Zabot/retrotype/README.md

# Retrotype
A control board retrofit for the Brother Comptronic 300M to convert it to an
RS232 teleprinter.
