Zabot/retrotype/pcb/drivers.kicad_sch

## KiCad design pcb/drivers.kicad_sch (2022-07-16)

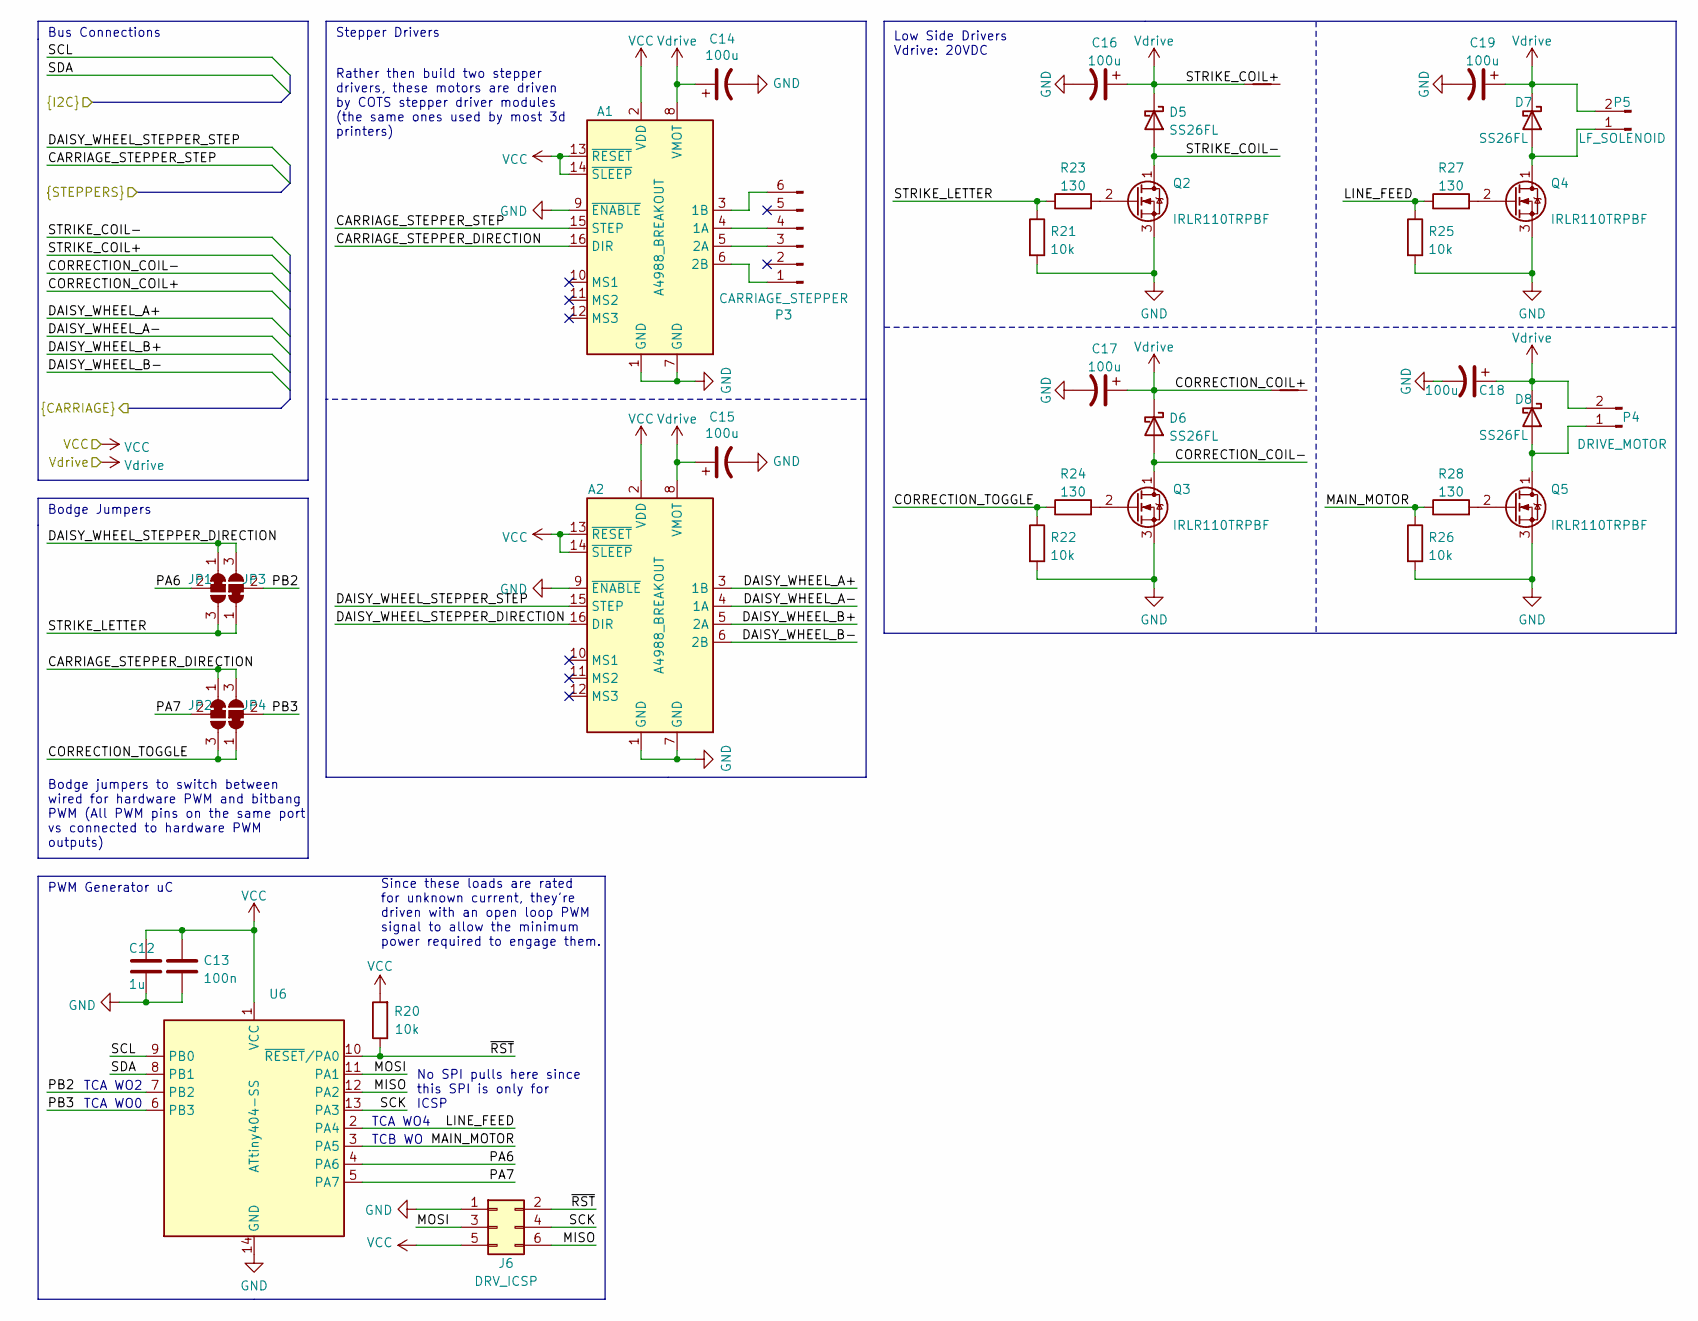
[picture p1: schematic drivers.kicad_sch]

Parts:
A1, A2: A4988_BREAKOUT; Pololu_Breakout-16_15.2x20.3mm
C12: 1u
C13: 100n
C14, C15, C16, C17, C18, C19: 100u
D5, D6, D7, D8: SS26FL
J6: DRV_ICSP
JP1, JP2, JP3, JP4: SolderJumper_3_Bridged12
NT2, NT3: NetTie_2
P3: CARRIAGE_STEPPER
P4: DRIVE_MOTOR
P5: LF_SOLENOID
Q2, Q3, Q4, Q5: IRLR110TRPBF
R20, R21, R22, R25, R26: 10k
R23, R24, R27, R28: 130
U6: ATtiny404-SS; SOIC-14_3.9x8.7mm_P1.27mm

Connections:
CARRIAGE_STEPPER_DIRECTION: A1.16 (DIR), JP2.1 (A), JP4.3 (B)
CARRIAGE_STEPPER_STEP: A1.15 (STEP)
CORRECTION_COIL+: NT3.2
CORRECTION_COIL-: D6.2 (A), Q3.1 (D)
CORRECTION_TOGGLE: JP2.3 (B), JP4.1 (A), R22.1, R24.1
DAISY_WHEEL_A+: A2.3 (1B)
DAISY_WHEEL_A-: A2.4 (1A)
DAISY_WHEEL_B+: A2.5 (2A)
DAISY_WHEEL_B-: A2.6 (2B)
DAISY_WHEEL_STEPPER_DIRECTION: A2.16 (DIR), JP1.1 (A), JP3.3 (B)
DAISY_WHEEL_STEPPER_STEP: A2.15 (STEP)
GND: A1.1 (GND), A1.7 (GND), A1.9 (~ENABLE), A2.1 (GND), A2.7 (GND), A2.9 (~ENABLE), C12.2, C13.2, C14.2, C15.2, C16.2, C17.2, C18.2, C19.2, J6.1, Q2.3 (S), Q3.3 (S), Q4.3 (S), Q5.3 (S), R21.2, R22.2, R25.2, R26.2, U6.14 (GND)
LINE_FEED: R25.1, R27.1, U6.2 (PA4)
MAIN_MOTOR: R26.1, R28.1, U6.3 (PA5)
MISO: J6.6, U6.12 (PA2)
MOSI: J6.3, U6.11 (PA1)
unnamed: A1.3 (1B), P3.6
unnamed: A1.4 (1A), P3.4
unnamed: A1.5 (2A), P3.3
unnamed: A1.6 (2B), P3.1
unnamed: D7.2 (A), P5.1, Q4.1 (D)
unnamed: D8.2 (A), P4.1, Q5.1 (D)
unnamed: Q2.2 (G), R23.2
unnamed: Q3.2 (G), R24.2
unnamed: Q4.2 (G), R27.2
unnamed: Q5.2 (G), R28.2
PA6: JP1.2 (C), U6.4 (PA6)
PA7: JP2.2 (C), U6.5 (PA7)
PB2: JP3.2 (C), U6.7 (PB2)
PB3: JP4.2 (C), U6.6 (PB3)
SCK: J6.4, U6.13 (PA3)
SCL: U6.9 (PB0)
SDA: U6.8 (PB1)
STRIKE_COIL+: NT2.2
STRIKE_COIL-: D5.2 (A), Q2.1 (D)
STRIKE_LETTER: JP1.3 (B), JP3.1 (A), R21.1, R23.1
VCC: A1.2 (VDD), A1.13 (~RESET), A1.14 (~SLEEP), A2.2 (VDD), A2.13 (~RESET), A2.14 (~SLEEP), C12.1, C13.1, J6.5, R20.2, U6.1 (VCC)
Vdrive: A1.8 (VMOT), A2.8 (VMOT), C14.1, C15.1, C16.1, C17.1, C18.1, C19.1, D5.1 (K), D6.1 (K), D7.1 (K), D8.1 (K), NT2.1, NT3.1, P4.2, P5.2
~RST: J6.2, R20.1, U6.10 (~RESET/PA0)

Notes on the sheet:
TCB WO
Rather then build two stepper drivers, these motors are driven by COTS stepper driver modules (the same ones used by most 3d printers)
TCA WO4
TCA WO0
Bodge Jumpers
Stepper Drivers
No SPI pulls here since this SPI is only for ICSP
Bodge jumpers to switch between wired for hardware PWM and bitbang PWM (All PWM pins on the same port vs connected to hardware PWM outputs)
Low Side Drivers Vdrive: 20VDC
PWM Generator uC
TCA WO2
Since these loads are rated for unknown current, they're driven with an open loop PWM signal to allow the minimum power required to engage them.
Bus Connections
