Zabot/retrotype/pcb/micro.kicad_sch

## KiCad design pcb/micro.kicad_sch (2022-07-16)

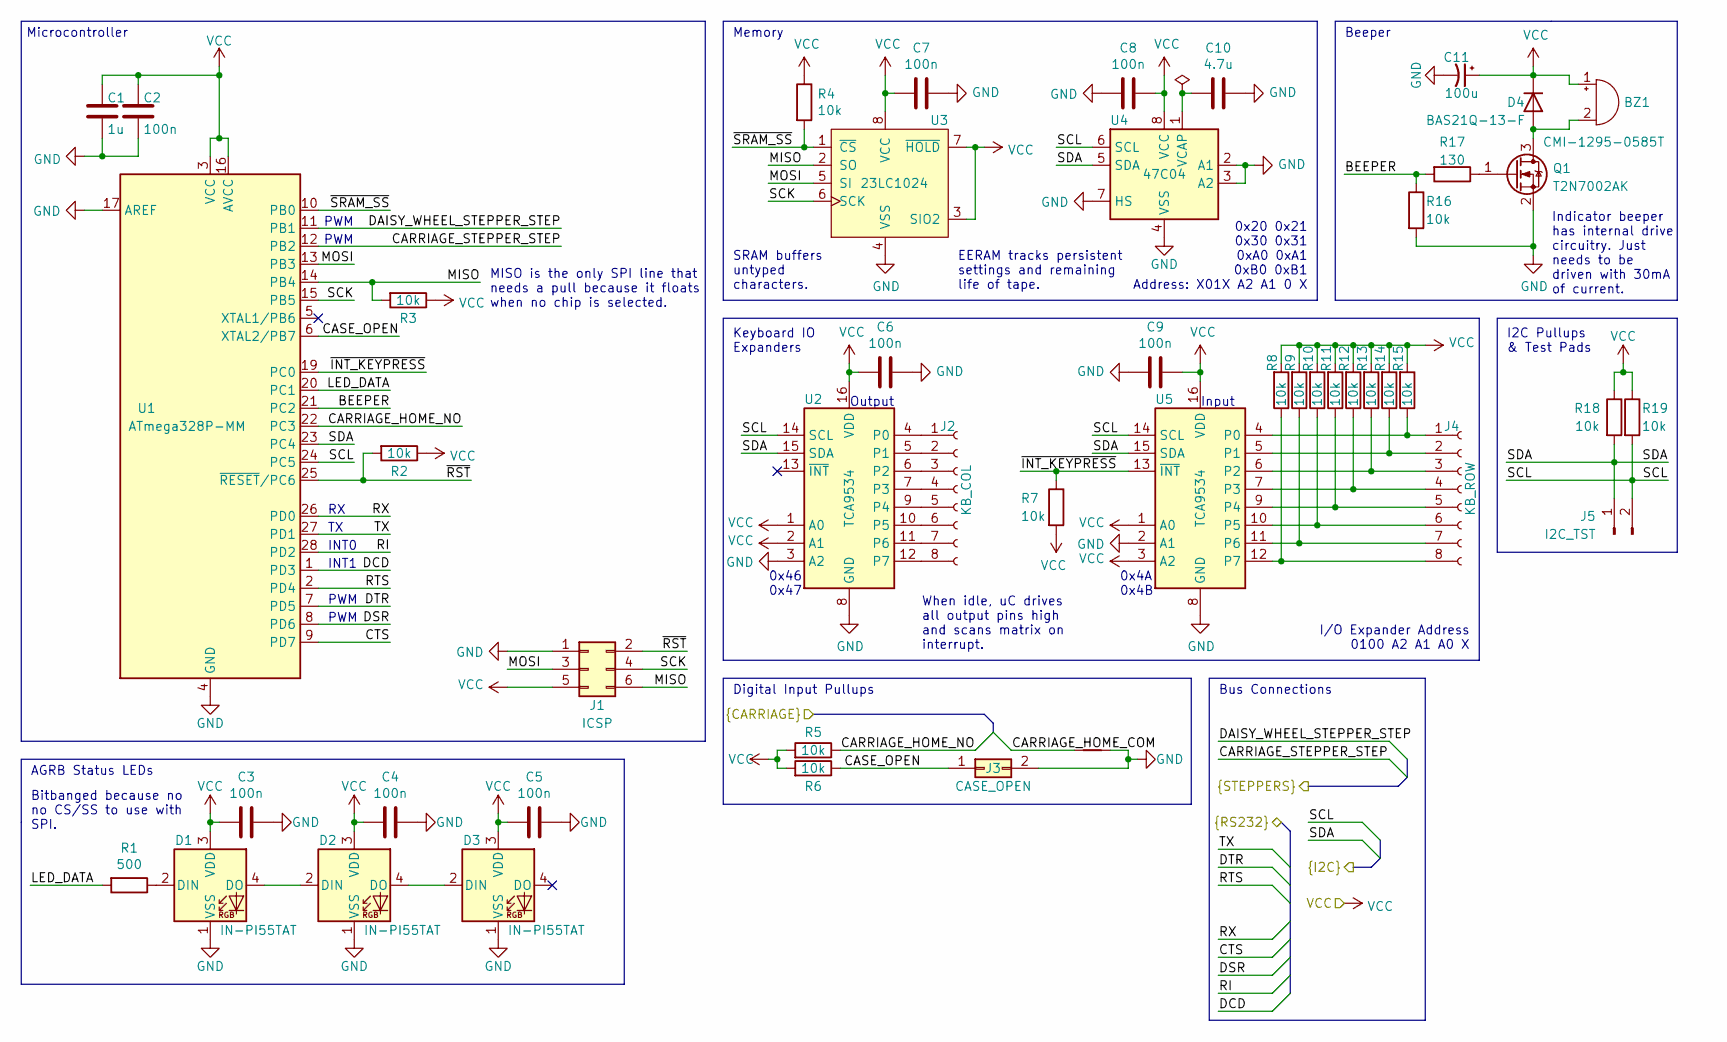
[picture p2: schematic micro.kicad_sch]

Parts:
BZ1: CMI-1295-0585T
C1: 1u
C2, C3, C4, C5, C6, C7, C8, C9: 100n
C10: 4.7u
C11: 100u
D1, D2, D3: IN-PI55TAT; LED_Inolux_IN-PI554FCH_PLCC4_5.0x5.0mm_P3.2mm
D4: BAS21Q-13-F
J1: ICSP
J2: KB_COL
J3: CASE_OPEN
J4: KB_ROW
J5: I2C_TST
NT1: NetTie_2
Q1: T2N7002AK
R1: 500
R2, R3, R4, R5, R6, R7, R8, R9, R10, R11, R12, R13, R14, R15, R16, R18, R19: 10k
R17: 130
U1: ATmega328P-MM; QFN-28-1EP_4x4mm_P0.45mm_EP2.4x2.4mm
U2, U5: TCA9534
U3: 23LC1024
U4: 47C04

Connections:
BEEPER: R16.1, R17.2, U1.21 (PC2)
CARRIAGE_HOME_COM: NT1.2
CARRIAGE_HOME_NO: R5.1, U1.22 (PC3)
CARRIAGE_STEPPER_STEP: U1.12 (PB2)
CASE_OPEN: J3.1, R6.1, U1.6 (XTAL2/PB7)
CTS: U1.9 (PD7)
DAISY_WHEEL_STEPPER_STEP: U1.11 (PB1)
DCD: U1.1 (PD3)
DSR: U1.8 (PD6)
DTR: U1.7 (PD5)
GND: C1.1, C2.1, C3.1, C4.1, C5.1, C6.1, C7.1, C8.2, C9.2, C10.1, C11.2, D1.1 (VSS), D2.1 (VSS), D3.1 (VSS), J1.1, J3.2, NT1.1, Q1.2 (S), R16.2, U1.4 (GND), U1.17 (AREF), U1.18 (GND), U1.29 (GND), U2.3 (A2), U2.8 (GND), U3.4 (VSS), U4.2 (A1), U4.3 (A2), U4.4 (VSS), U4.7 (HS), U5.2 (A1), U5.8 (GND)
LED_DATA: R1.2, U1.20 (PC1)
MISO: J1.6, R3.2, U1.14 (PB4), U3.2 (SO)
MOSI: J1.3, U1.13 (PB3), U3.5 (SI)
unnamed: BZ1.2 (+), D4.2 (A), Q1.3 (D)
unnamed: C10.2, U4.1 (VCAP)
unnamed: D1.2 (DIN), R1.1
unnamed: D1.4 (DO), D2.2 (DIN)
unnamed: D2.4 (DO), D3.2 (DIN)
unnamed: J2.1, U2.4 (P0)
unnamed: J2.2, U2.5 (P1)
unnamed: J2.3, U2.6 (P2)
unnamed: J2.4, U2.7 (P3)
unnamed: J2.5, U2.9 (P4)
unnamed: J2.6, U2.10 (P5)
unnamed: J2.7, U2.11 (P6)
unnamed: J2.8, U2.12 (P7)
unnamed: J4.1, R15.1, U5.4 (P0)
unnamed: J4.2, R14.1, U5.5 (P1)
unnamed: J4.3, R13.1, U5.6 (P2)
unnamed: J4.4, R12.1, U5.7 (P3)
unnamed: J4.5, R11.1, U5.9 (P4)
unnamed: J4.6, R10.1, U5.10 (P5)
unnamed: J4.7, R9.1, U5.11 (P6)
unnamed: J4.8, R8.1, U5.12 (P7)
unnamed: Q1.1 (G), R17.1
RI: U1.28 (PD2)
RTS: U1.2 (PD4)
RX: U1.26 (PD0)
SCK: J1.4, U1.15 (PB5), U3.6 (SCK)
SCL: J5.2, R19.2, U1.24 (PC5), U2.14 (SCL), U4.6 (SCL), U5.14 (SCL)
SDA: J5.1, R18.2, U1.23 (PC4), U2.15 (SDA), U4.5 (SDA), U5.15 (SDA)
TX: U1.27 (PD1)
VCC: BZ1.1 (-), C1.2, C2.2, C3.2, C4.2, C5.2, C6.2, C7.2, C8.1, C9.1, C11.1, D1.3 (VDD), D2.3 (VDD), D3.3 (VDD), D4.1 (K), J1.5, R2.1, R3.1, R4.1, R5.2, R6.2, R7.2, R8.2, R9.2, R10.2, R11.2, R12.2, R13.2, R14.2, R15.2, R18.1, R19.1, U1.3 (VCC), U1.16 (AVCC), U2.1 (A0), U2.2 (A1), U2.16 (VDD), U3.3 (SIO2), U3.7 (~HOLD), U3.8 (VCC), U4.8 (VCC), U5.1 (A0), U5.3 (A2), U5.16 (VDD)
~INT_KEYPRESS: R7.1, U1.19 (PC0), U5.13 (~INT)
~RST: J1.2, R2.2, U1.25 (~RESET/PC6)
~SRAM_SS: R4.2, U1.10 (PB0), U3.1 (~CS)

Notes on the sheet:
Output
Beeper
Microcontroller
Memory
SRAM buffers untyped characters.
PWM
When idle, uC drives all output pins high and scans matrix on interrupt.
0x4A 0x4B
MISO is the only SPI line that needs a pull because it floats when no chip is selected.
0x46 0x47
INT1
Indicator beeper has internal drive circuitry. Just needs to be driven with 30mA of current.
Digital Input Pullups
Input
0x20 0x21 0x30 0x31 0xA0 0xA1 0xB0 0xB1 Address: X01X A2 A1 0 X
I2C Pullups & Test Pads
AGRB Status LEDs
Bus Connections
I/O Expander Address 0100 A2 A1 A0 X
INT0
Bitbanged because no no CS/SS to use with SPI.
EERAM tracks persistent settings and remaining life of tape.
Keyboard IO Expanders
