Zabot/retrotype/pcb/psu.kicad_sch

## KiCad design pcb/psu.kicad_sch (2022-07-16)

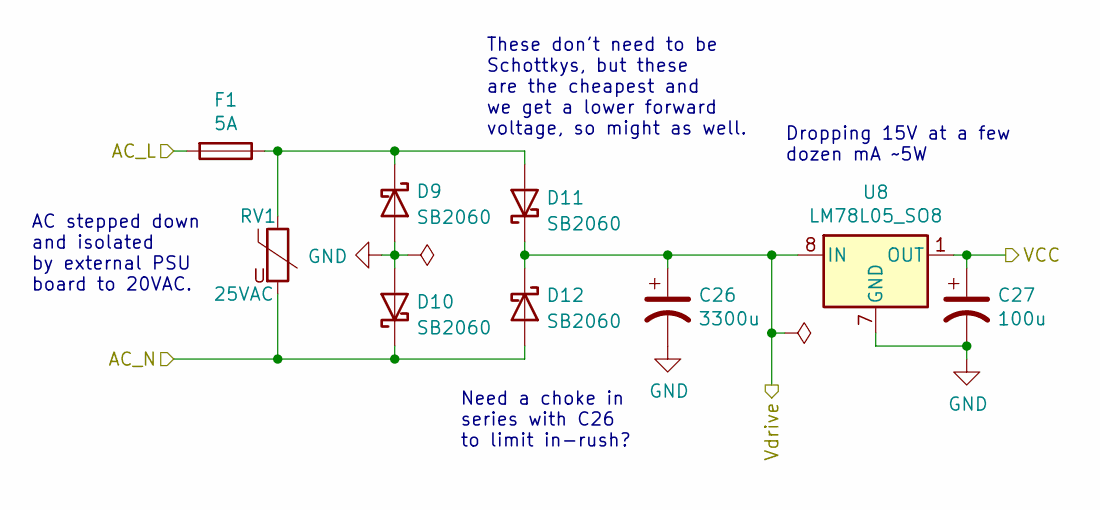
[picture p3: schematic psu.kicad_sch]

Parts:
C26: 3300u
C27: 100u
D9, D10, D11, D12: SB2060
F1: 5A
RV1: 25VAC
U8: LM78L05_SO8; SOIC-8_3.9x4.9mm_P1.27mm

Connections:
AC_L: F1.2
AC_N: D10.1 (K), D12.2 (A), RV1.2
GND: C26.2, C27.2, D9.2 (A), D10.2 (A), U8.2 (GND), U8.3 (GND), U8.6 (GND), U8.7 (GND)
unnamed: D9.1 (K), D11.2 (A), F1.1, RV1.1
VCC: C27.1, U8.1 (OUT)
Vdrive: C26.1, D11.1 (K), D12.1 (K), U8.8 (IN)

Notes on the sheet:
Dropping 15V at a few dozen mA ~5W
Need a choke in series with C26 to limit in-rush?
These don't need to be Schottkys, but these are the cheapest and we get a lower forward voltage, so might as well.
AC stepped down and isolated by external PSU board to 20VAC.
