Zabot/retrotype/pcb/retrotype.kicad_sch

## KiCad design pcb/retrotype.kicad_sch (2022-07-16)

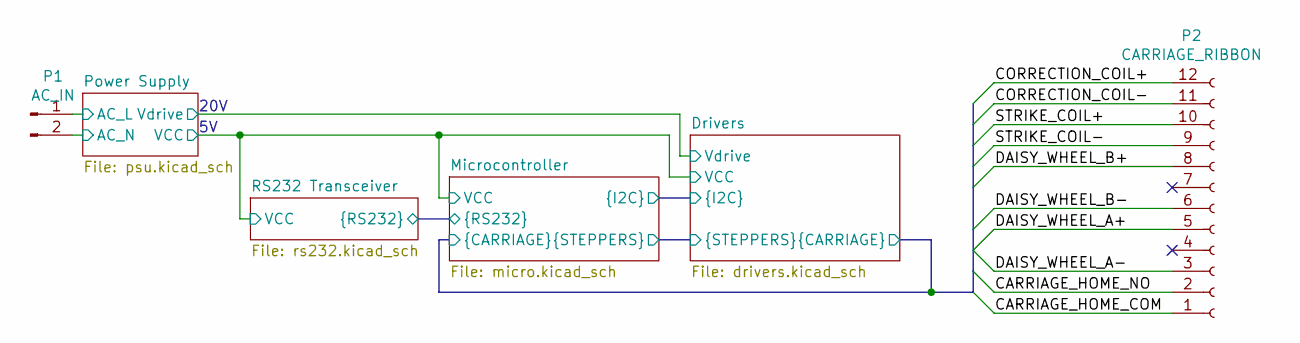
[picture p4: schematic retrotype.kicad_sch]

Parts:
P1: AC_IN
P2: CARRIAGE_RIBBON

Connections:
AC_L: P1.1
AC_N: P1.2
CARRIAGE_HOME_COM: P2.1
CARRIAGE_HOME_NO: P2.2
CORRECTION_COIL+: P2.12
CORRECTION_COIL-: P2.11
DAISY_WHEEL_A+: P2.5
DAISY_WHEEL_A-: P2.3
DAISY_WHEEL_B+: P2.8
DAISY_WHEEL_B-: P2.6
STRIKE_COIL+: P2.10
STRIKE_COIL-: P2.9

Notes on the sheet:
20V
