Zabot/retrotype/pcb/rs232.kicad_sch

## KiCad design pcb/rs232.kicad_sch (2022-07-16)

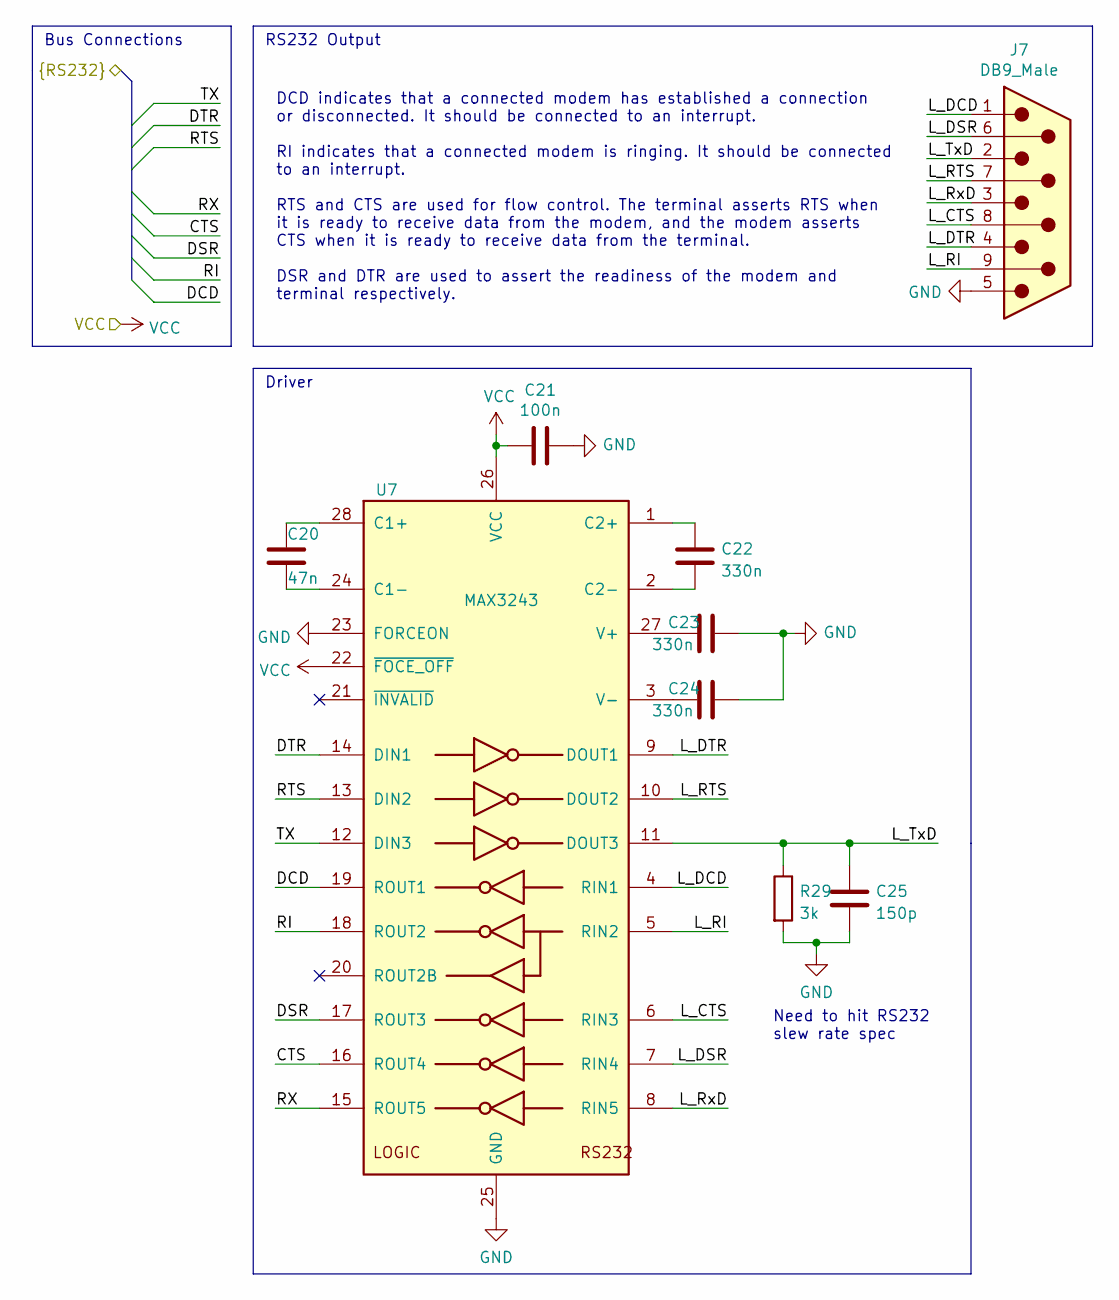
[picture p5: schematic rs232.kicad_sch]

Parts:
C20: 47n
C21: 100n
C22, C23, C24: 330n
C25: 150p
J7: DB9_Male
R29: 3k
U7: MAX3243

Connections:
CTS: U7.16 (ROUT4)
DCD: U7.19 (ROUT1)
DSR: U7.17 (ROUT3)
DTR: U7.14 (DIN1)
GND: C21.1, C23.2, C24.2, C25.2, J7.5, R29.2, U7.23 (FORCEON), U7.25 (GND)
L_CTS: J7.8, U7.6 (RIN3)
L_DCD: J7.1, U7.4 (RIN1)
L_DSR: J7.6, U7.7 (RIN4)
L_DTR: J7.4, U7.9 (DOUT1)
L_RI: J7.9, U7.5 (RIN2)
L_RTS: J7.7, U7.10 (DOUT2)
L_RxD: J7.3, U7.8 (RIN5)
L_TxD: C25.1, J7.2, R29.1, U7.11 (DOUT3)
unnamed: C20.1, U7.28 (C1+)
unnamed: C20.2, U7.24 (C1-)
unnamed: C22.1, U7.1 (C2+)
unnamed: C22.2, U7.2 (C2-)
unnamed: C23.1, U7.27 (V+)
unnamed: C24.1, U7.3 (V-)
RI: U7.18 (ROUT2)
RTS: U7.13 (DIN2)
RX: U7.15 (ROUT5)
TX: U7.12 (DIN3)
VCC: C21.2, U7.22 (~FOCE_OFF), U7.26 (VCC)

Notes on the sheet:
Need to hit RS232 slew rate spec
Bus Connections
RS232 Output
DCD indicates that a connected modem has established a connection or disconnected. It should be connected to an interrupt. RI indicates that a connected modem is ringing. It should be connected to an interrupt. RTS and CTS are used for flow control. The terminal asserts RTS when it is ready to rece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
Driver
