Zabot/retrotype/(commit log)

2022-07-16 Control board revision 1
    [drivers.kicad_sch, micro.kicad_sch, psu.kicad_sch, rs232.kicad_sch, typewriter.kicad_sch]
2022-07-16 Tweak PSU
    [drivers.kicad_sch, micro.kicad_sch, psu.kicad_sch, rs232.kicad_sch, typewriter.kicad_sch]
2022-07-16 Add MOV to protect full bridge
    [micro.kicad_sch, psu.kicad_sch, typewriter.kicad_sch]
2022-07-16 Rename kicad project
    [micro.kicad_sch, retrotype.kicad_sch, rs232.kicad_sch]
2022-07-16 Firmware blink LED
